hans61/Minimal-64x4-Expansion/README.md

# Minimal-64x4-Expansion

Hardware
https://github.com/hans61/Minimal-64x4-Expansion/tree/main/hardware

Software
https://github.com/hans61/Minimal-64x4-Expansion/tree/main/software
