hans61/Minimal-64x4-Expansion/hardware/Rev.7/README.md

# Minimal-64x4 Expansion Rev.7

Revision 7 extends the previous one with a power ON reset based on a NE555.

Revision 6: https://github.com/hans61/Minimal-64x4-Expansion/tree/main/hardware/Rev.6

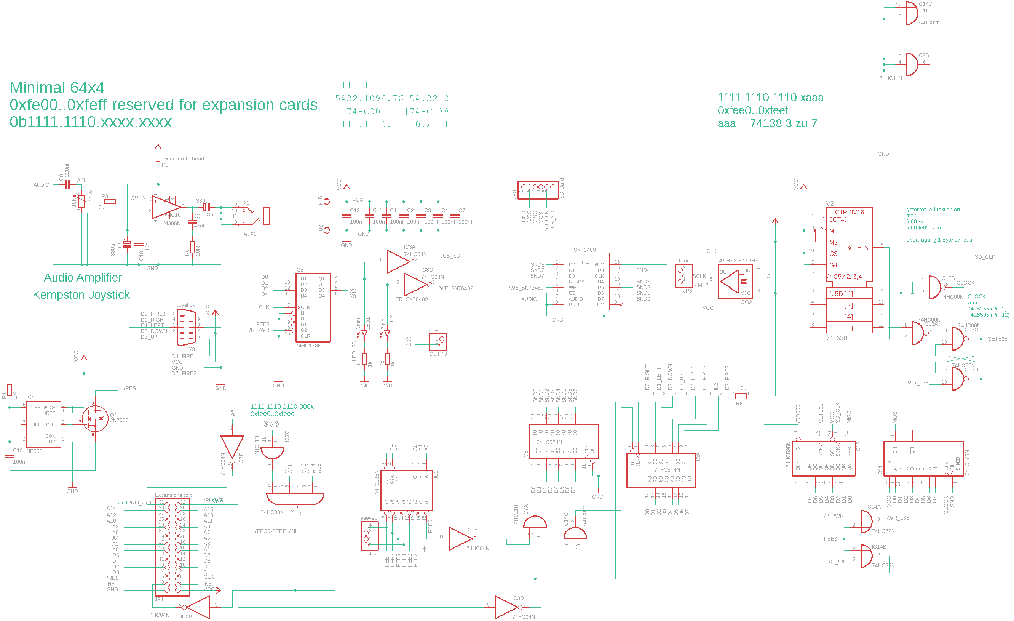
[picture p5: hardware/Rev.7/expansion-sn76489-kempton-sd-rev7.sch.png]
schematic
