hans61/Minimal-64x4-Expansion/software/sn76489/README.md

# SN76489 tests

Simple sound tests for the SN76489. A sequence of tones is played, which can be repeated at the touch of a button.
