hans61/Minimal-64x4-Expansion/hardware/Rev.7/pic/minimal64x4-expansion-rev7-top.jpg

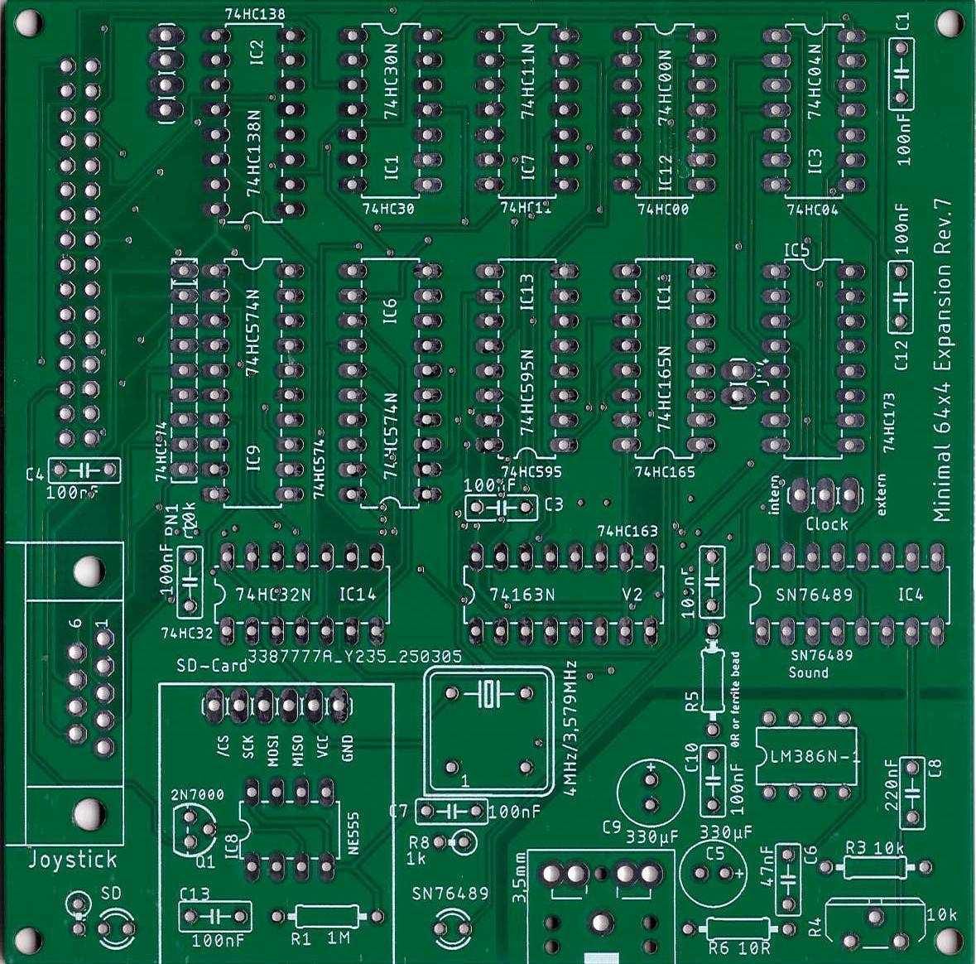
hardware/Rev.7/pic/minimal64x4-expansion-rev7-top.jpg
