hans61/Minimal-64x4-Expansion/hardware/Rev.7/eagle/expansion-sn76489-kempton-sd-rev7.brd

## EAGLE design hardware/Rev.7/eagle/expansion-sn76489-kempton-sd-rev7.brd (2025-03-06)

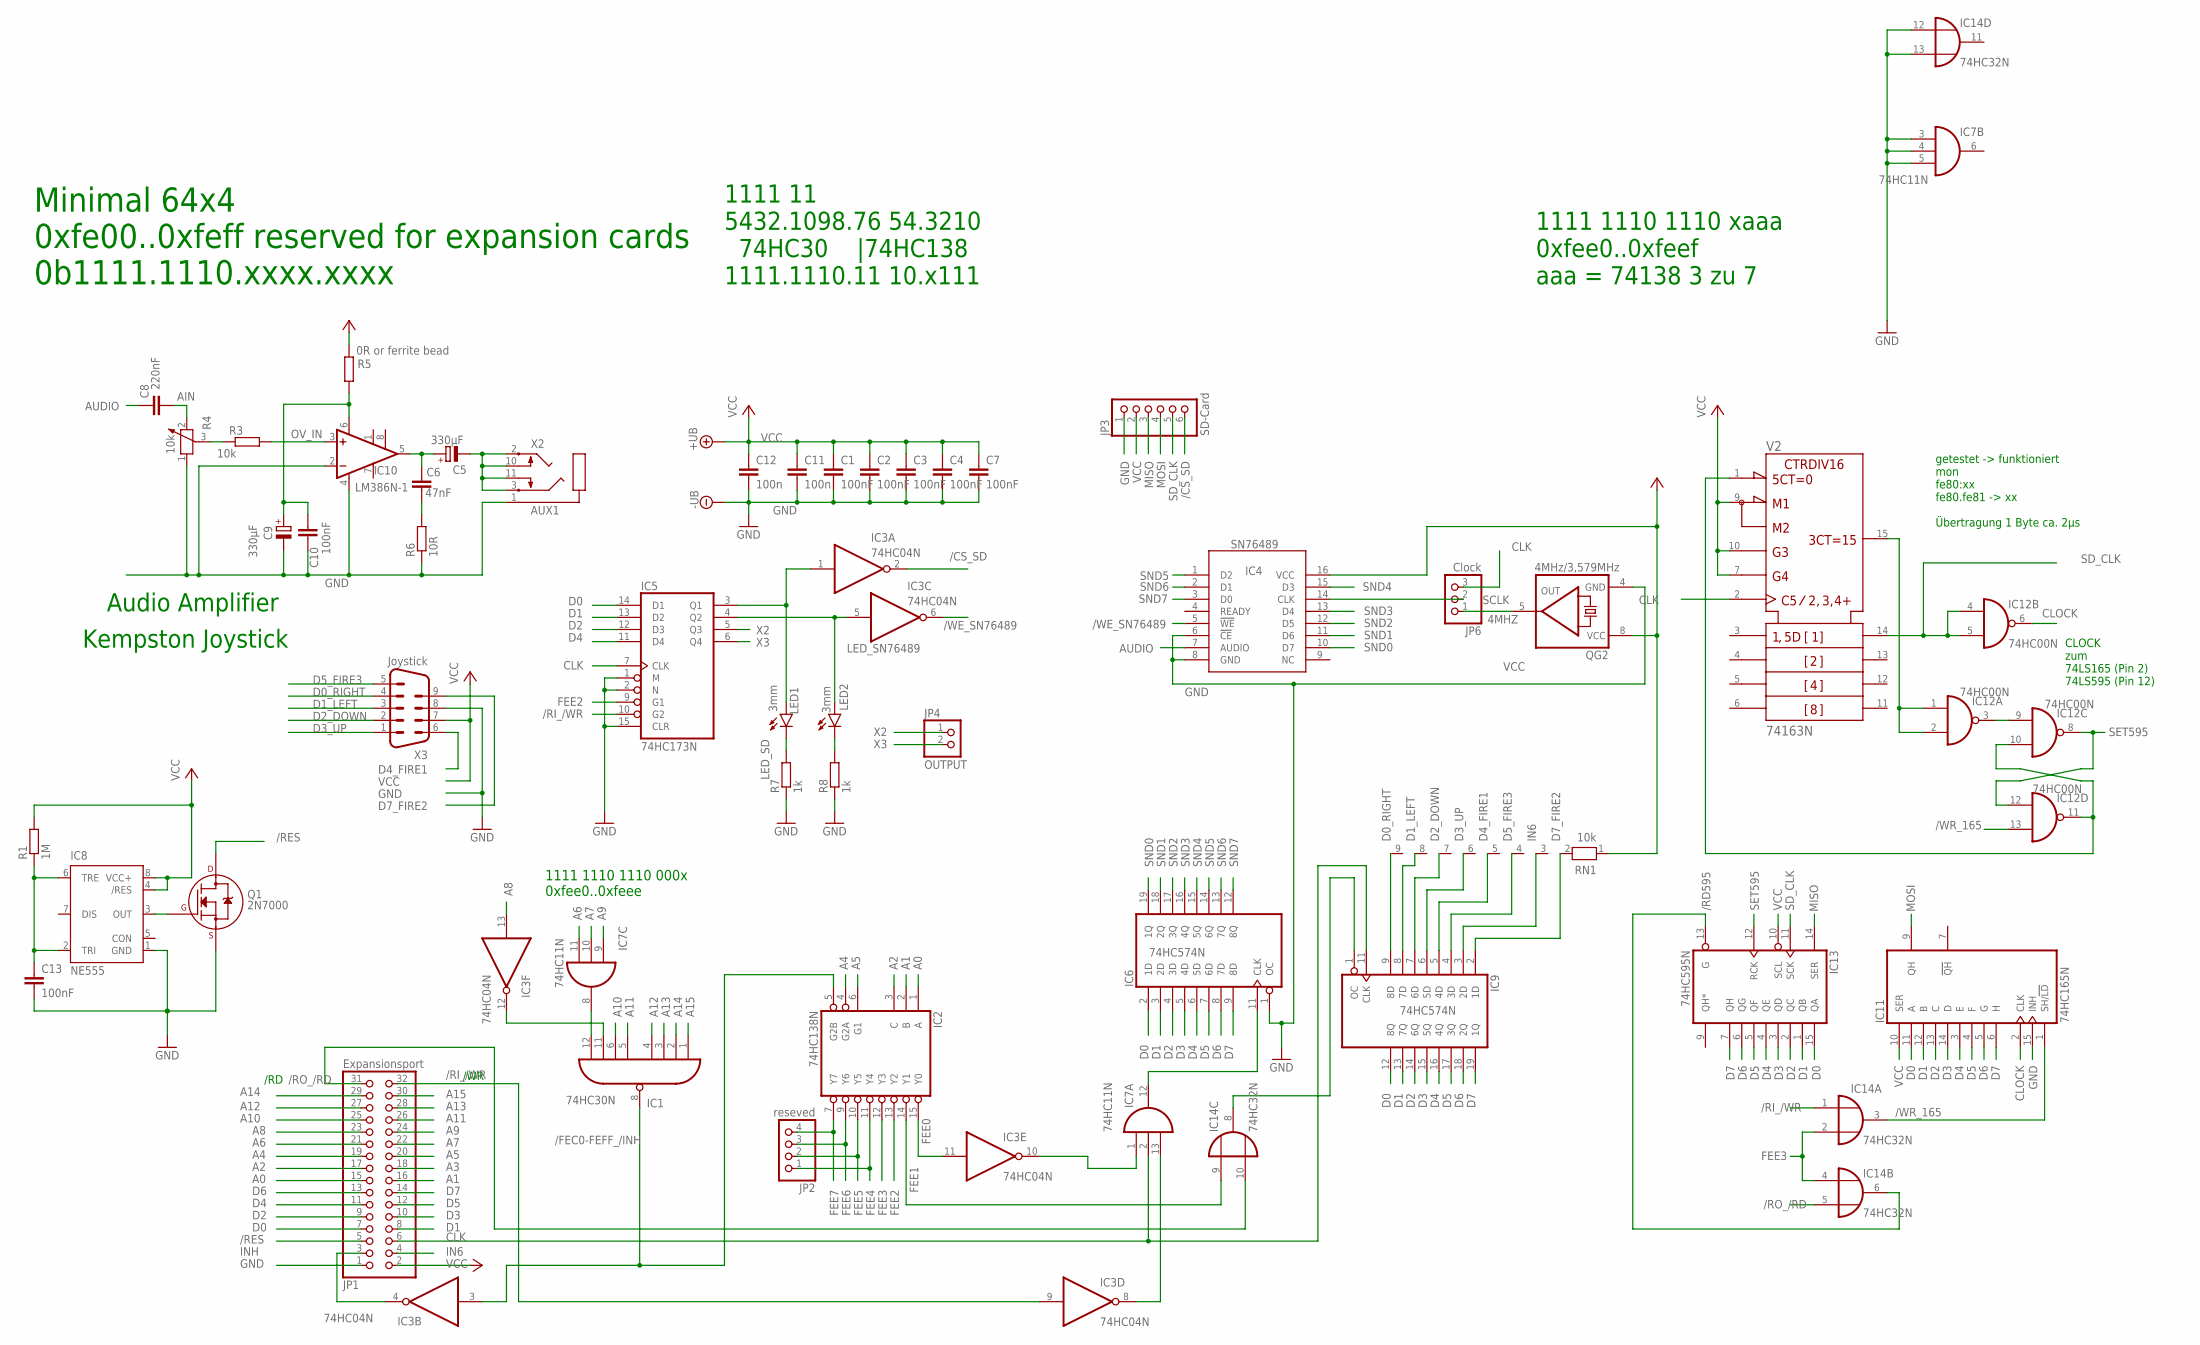
[picture p9: schematic expansion-sn76489-kempton-sd-rev7.sch]

Parts:
C1, C2, C3, C4, C7, C10: 100nF; C050-025X075
C5, C9: 330µF; E2,5-7
C6: 47nF; C050-025X075
C8: 220nF; C050-025X075
C11, C12: 100n; C050-025X075
C13: 100nF; C050-030X075
IC1: 74HC30N; DIL14
IC2: 74HC138N; DIL16
IC3: 74HC04N; DIL14
IC4: SN76489; ALEX-PARTS_DIL16
IC5: 74HC173N; DIL16
IC6, IC9: 74HC574N; DIL20
IC7: 74HC11N; DIL14
IC8: NE555; DIL-08
IC10: LM386N-1; DIL08
IC11: 74HC165N; DIL16
IC12: 74HC00N; DIL14
IC13: 74HC595N; DIL16
IC14: 74HC32N; DIL14
JP1: Expansionsport; 2X16
JP2: reseved; 1X04
JP3: SD-Card; 1X06
JP4: OUTPUT; 1X02
JP6: Clock; 1X03
LED1, LED2: 3mm; LED3MM
Q1: 2N7000; TO-92
QG2: 4MHz/3,579MHz; DIL08S
R1: 1M; 0207/10
R3: 10k; 0207/10
R4: 10k; PT-10S
R5: 0R or ferrite bead; 0207/10
R6: 10R; 0207/10
R7, R8: 1k; 0207/2V
RN1: 10k; RN-9
V2: 74163N; DIL16
X2: AUX1; SJ1-352XN
X3: Joystick; 182-009-MALE

Connections:
4MHZ: JP6.1, QG2.5 (OUT)
/CS_SD: IC3.2 (O), JP3.6
/FEC0-FEFF_/INH: IC1.8 (O), IC2.5 (G2B), IC3.3 (I)
/RD595: IC13.13 (G), IC14.6 (O)
/RES: JP1.5, Q1.3 (D)
/RI_/WR: IC3.9 (I), IC5.10 (G2), IC14.1 (I0), JP1.32
/RO_/RD: IC14.5 (I1), IC14.10 (I1), JP1.31
/WE_SN76489: IC3.6 (O), IC4.5 (!WE)
/WR_165: IC11.1 (SH/!LD), IC12.13 (I1), IC14.3 (O)
A0: IC2.1 (A), JP1.15
A1: IC2.2 (B), JP1.16
A2: IC2.3 (C), JP1.17
A3: JP1.18
A4: IC2.4 (G2A), JP1.19
A5: IC2.6 (G1), JP1.20
A6: IC7.11 (I2), JP1.21
A7: IC7.10 (I1), JP1.22
A8: IC3.13 (I), JP1.23
A9: IC7.9 (I0), JP1.24
A10: IC1.6 (I5), JP1.25
A11: IC1.5 (I4), JP1.26
A12: IC1.4 (I3), JP1.27
A13: IC1.3 (I2), JP1.28
A14: IC1.2 (I1), JP1.29
A15: IC1.1 (I0), JP1.30
AIN: C8.2, R4.2
AUDIO: C8.1, IC4.7 (AUDIO)
AUXOUT1: C5.-, X2.2, X2.3, X2.10, X2.11
AVCC: C9.+, C10.1, IC10.6 (VS), R5.1
CLK: IC5.7 (CLK), IC7.2 (I1), IC9.11 (CLK), JP1.6, JP6.3, V2.2 (CLK)
CLOCK: IC11.2 (CLK), IC12.6 (O)
D0: IC5.14 (D1), IC6.2 (1D), IC9.12 (8Q), IC11.11 (A), IC13.15 (QA), JP1.7
D0_RIGHT: IC9.9 (8D), RN1.9, X3.4
D1: IC5.13 (D2), IC6.3 (2D), IC9.13 (7Q), IC11.12 (B), IC13.1 (QB), JP1.8
D1_LEFT: IC9.8 (7D), RN1.8, X3.3
D2: IC5.12 (D3), IC6.4 (3D), IC9.14 (6Q), IC11.13 (C), IC13.2 (QC), JP1.9
D2_DOWN: IC9.7 (6D), RN1.7, X3.2
D3: IC6.5 (4D), IC9.15 (5Q), IC11.14 (D), IC13.3 (QD), JP1.10
D3_UP: IC9.6 (5D), RN1.6, X3.1
D4: IC5.11 (D4), IC6.6 (5D), IC9.16 (4Q), IC11.3 (E), IC13.4 (QE), JP1.11
D4_FIRE1: IC9.5 (4D), RN1.5, X3.6
D5: IC6.7 (6D), IC9.17 (3Q), IC11.4 (F), IC13.5 (QF), JP1.12
D5_FIRE3: IC9.4 (3D), RN1.4, X3.5
D6: IC6.8 (7D), IC9.18 (2Q), IC11.5 (G), IC13.6 (QG), JP1.13
D7: IC6.9 (8D), IC9.19 (1Q), IC11.6 (H), IC13.7 (QH), JP1.14
D7_FIRE2: IC9.2 (1D), RN1.2, X3.9
FEE0: IC2.15 (Y0), IC3.11 (I)
FEE1: IC2.14 (Y1), IC14.9 (I0)
FEE2: IC2.13 (Y2), IC5.9 (G1)
FEE3: IC2.12 (Y3), IC14.2 (I1), IC14.4 (I0)
FEE4: IC2.11 (Y4), JP2.1
FEE5: IC2.10 (Y5), JP2.2
FEE6: IC2.9 (Y6), JP2.3
FEE7: IC2.7 (Y7), JP2.4
GND: C1.2, C2.2, C3.2, C4.2, C7.2, C9.-, C10.2, C11.2, C12.2, C13.2, IC1.7 (GND), IC2.8 (GND), IC3.7 (GND), IC4.6 (!CE), IC4.8 (GND), IC5.1 (M), IC5.2 (N), IC5.8 (GND), IC5.15 (CLR), IC6.1 (OC), IC6.10 (GND), IC7.3 (I0), IC7.4 (I1), IC7.5 (I2), IC7.7 (GND), IC8.1 (GND), IC9.10 (GND), IC10.2 (-IN), IC10.4 (GND), IC11.8 (GND), IC11.15 (INH), IC12.7 (GND), IC13.8 (GND), IC14.7 (GND), IC14.12 (I0), IC14.13 (I1), JP1.1, JP3.1, Q1.1 (S), QG2.4 (GND), R4.1, R6.1, R7.1, R8.1, V2.8 (-UB), X2.1, X3.8
IN6: IC9.3 (2D), JP1.4, RN1.3
INH: IC3.4 (O), JP1.3
INPUT_EN: IC9.1 (OC), IC14.8 (O)
LED_SD: IC3.1 (I), IC5.3 (Q1), LED1.A
LED_SN76489: IC3.5 (I), IC5.4 (Q2), LED2.A
MISO: IC13.14 (SER), JP3.3
MOSI: IC11.9 (QH), JP3.4
unnamed: LED2.K (C), R8.2
unnamed: IC3.10 (O), IC7.1 (I0)
unnamed: IC1.12 (I7), IC7.8 (O)
unnamed: C13.1, IC8.2 (TRI), IC8.6 (TRE), R1.1
unnamed: IC8.3 (OUT), Q1.2 (G)
unnamed: C6.2, R6.2
unnamed: IC12.1 (I0), IC12.2 (I1), V2.15 (RCO)
unnamed: R3.1, R4.3
unnamed: IC12.10 (I1), IC12.11 (O), V2.1 (!CLR)
unnamed: IC12.3 (O), IC12.9 (I0)
unnamed: LED1.K (C), R7.2
unnamed: IC1.11 (I6), IC3.12 (O)
OV_IN: IC10.3 (+IN), R3.2
R2C2C3: C5.+, C6.1, IC10.5 (OUT)
RI_WR: IC3.8 (O), IC7.13 (I2)
SCLK: IC4.14 (CLK), JP6.2
SD_CLK: IC12.4 (I0), IC12.5 (I1), IC13.11 (SCK), JP3.5, V2.14 (QA)
SET595: IC12.8 (O), IC12.12 (I0), IC13.12 (RCK)
SND0: IC4.10 (D7), IC6.19 (1Q)
SND1: IC4.11 (D6), IC6.18 (2Q)
SND2: IC4.12 (D5), IC6.17 (3Q)
SND3: IC4.13 (D4), IC6.16 (4Q)
SND4: IC4.15 (D3), IC6.15 (5Q)
SND5: IC4.1 (D2), IC6.14 (6Q)
SND6: IC4.2 (D1), IC6.13 (7Q)
SND7: IC4.3 (D0), IC6.12 (8Q)
SOUND_EN: IC6.11 (CLK), IC7.12 (O)
VCC: C1.1, C2.1, C3.1, C4.1, C7.1, C11.1, C12.1, IC1.14 (VCC), IC2.16 (VCC), IC3.14 (VCC), IC4.16 (VCC), IC5.16 (VCC), IC6.20 (VCC), IC7.14 (VCC), IC8.4 (/RES), IC8.8 (VCC+), IC9.20 (VCC), IC11.10 (SER), IC11.16 (VCC), IC12.14 (VCC), IC13.10 (SCL), IC13.16 (VCC), IC14.14 (VCC), JP1.2, JP3.2, QG2.8 (VCC), R1.2, R5.2, RN1.1, V2.7 (ENP), V2.9 (!LOAD), V2.10 (ENT), V2.16 (+UB), X3.7
X2: IC5.5 (Q3), JP4.1
X3: IC5.6 (Q4), JP4.2

Notes on the sheet:
1111 1110 1110 xaaa 0xfee0..0xfeef aaa = 74138 3 zu 7
1111 1110 1110 000x 0xfee0..0xfeee
/WR
/RD
Minimal 64x4 0xfe00..0xfeff reserved for expansion cards 0b1111.1110.xxxx.xxxx
1111 11 5432.1098.76 54.3210 74HC30 |74HC138 1111.1110.11 10.x111
Kempston Joystick
Audio Amplifier
CLOCK zum 74LS165 (Pin 2) 74LS595 (Pin 12)
getestet -> funktioniert mon fe80:xx fe80.fe81 -> xx Übertragung 1 Byte ca. 2µs

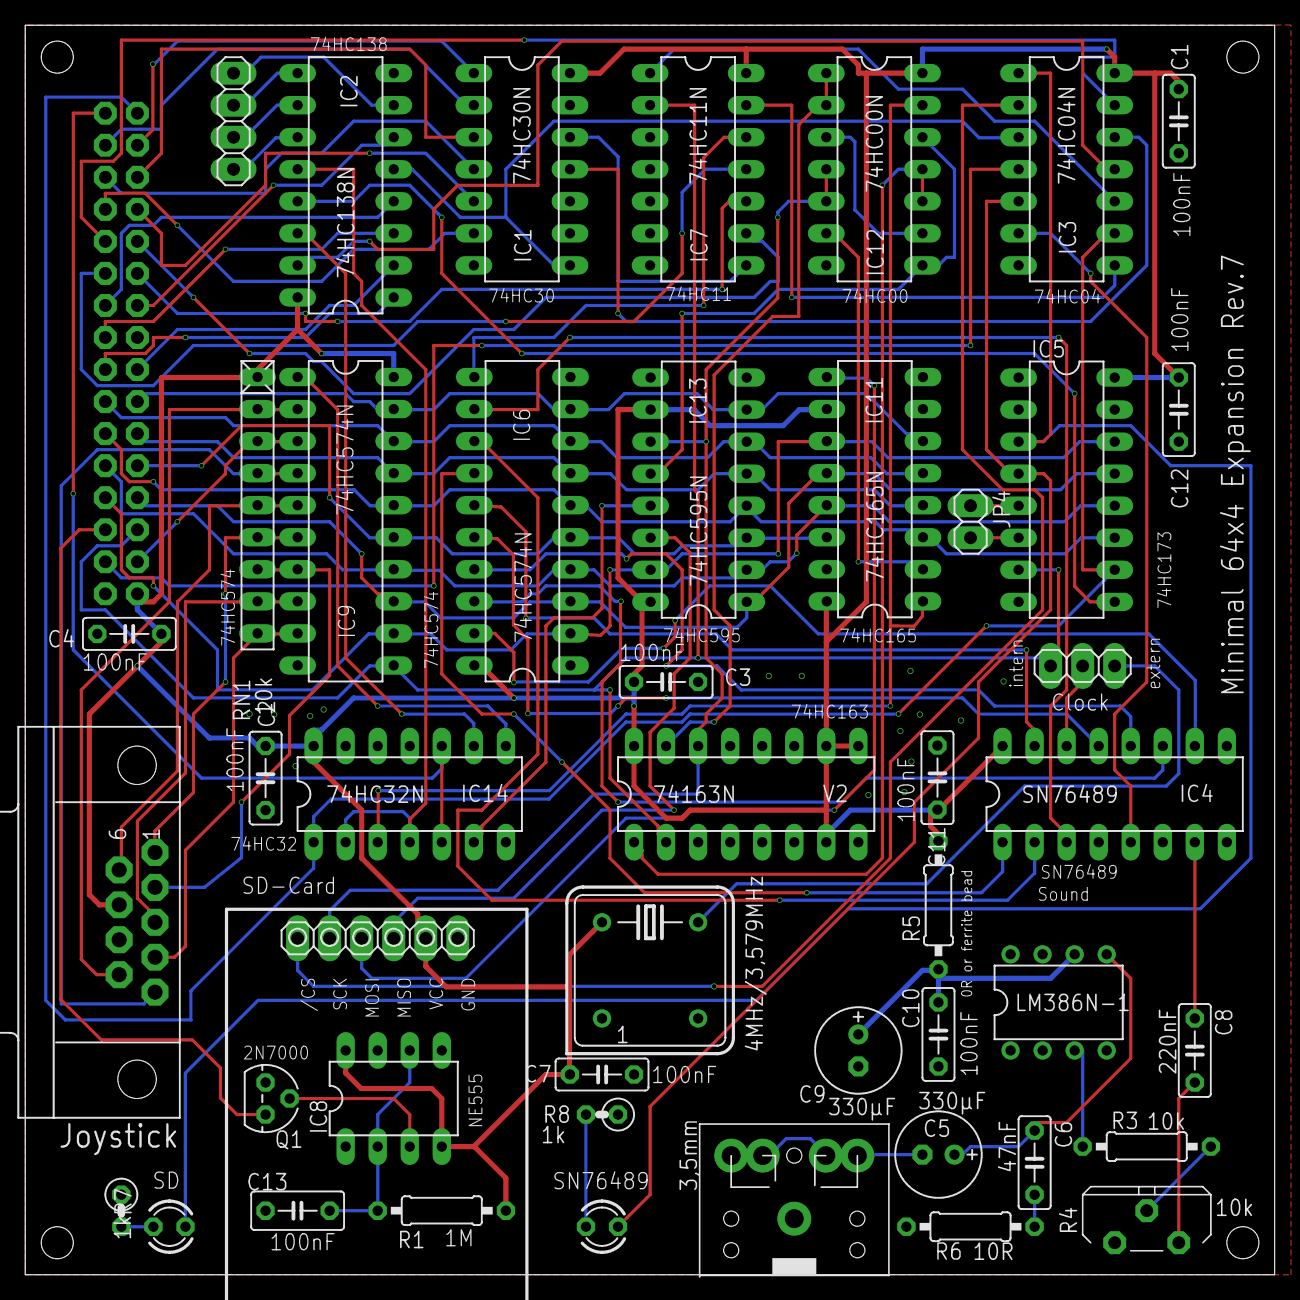
[picture p10: board expansion-sn76489-kempton-sd-rev7.brd from above]

Board: 2 copper layers, 99.0 x 99.0 mm, 47 parts (1 on the bottom side), 91 nets.
