hans61/Minimal-64x4-Expansion/(commit log)

2025-01-12 first files
    [expansion-sn76489-kempton-sd-rev6.brd, expansion-sn76489-kempton-sd-rev6.sch]
2025-03-06 revision 7 of the expansion board
    [expansion-sn76489-kempton-sd-rev7.brd, expansion-sn76489-kempton-sd-rev7.sch]
